SethNeumann/MRCS-Dual-3-Position-Semaphore-Controller/MRCS-Dual-3-Position-Semaphore-Controller v16.brd

## EAGLE design MRCS-Dual-3-Position-Semaphore-Controller v16.brd (2025-08-24)

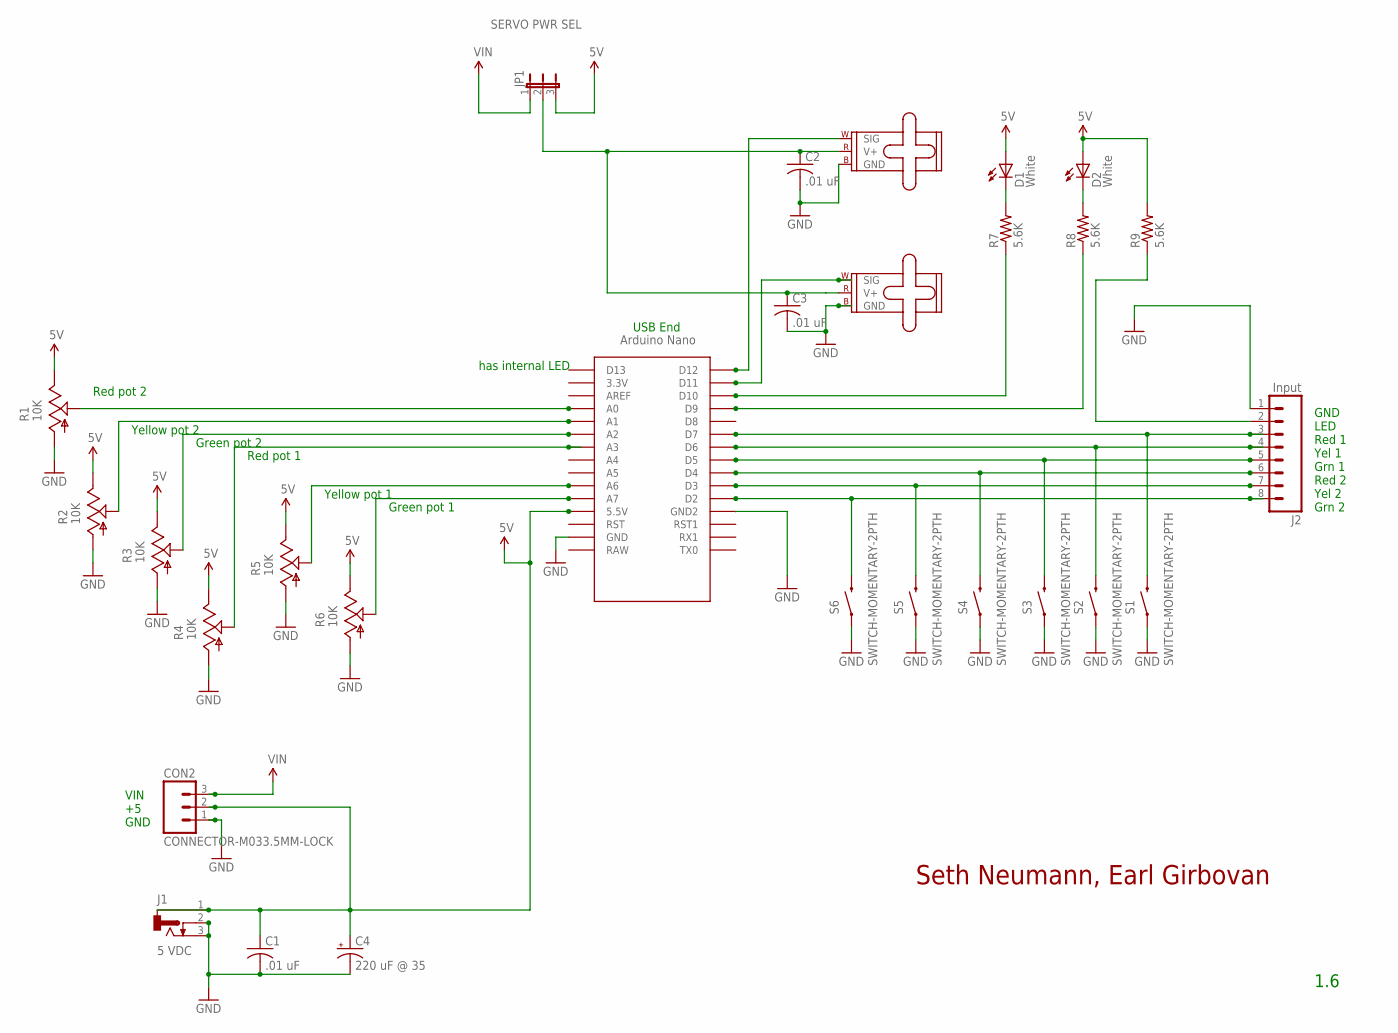
[picture p37: schematic MRCS-Dual-3-Position-Semaphore-Controller v16.sch]

Parts:
C1, C2, C3: .01 uF; C050-024X044
C4: 220 uF @ 35; E5-10.5
CON2: CONNECTOR-M033.5MM-LOCK; SCREWTERMINAL-3.5MM-3_LOCK.007S
D1, D2: White; LED3MM
J1: 5 VDC; DCJ0202
J2: Input; 1X08_LOCK
JP1: SERVO PWR SEL; 1X03
M1, M2: SMALL_SERVO; 1X03
NANO: NANO
R1, R2, R3, R4, R5, R6: 10K; RS3
R7, R8, R9: 5.6K; AXIAL-0.4
S1, S2, S3, S4, S5, S6: SWITCH-MOMENTARY-2PTH; TACTILE-PTH

Connections:
5V: C1.1, C4.+, CON2.2, D1.A, D2.A, J1.1, JP1.3, NANO.5V (5.5V), R1.E, R2.E, R3.E, R4.E, R5.E, R6.E, R9.P$2 (2)
A0: NANO.A0, R1.S
A1: NANO.A1, R2.S
A2: NANO.A2, R3.S
A3: NANO.A3, R4.S
A6: NANO.A6, R5.S
A7: NANO.A7, R6.S
D2: J2.8, NANO.D2, S6.3 (2)
D3: J2.7, NANO.D3, S5.3 (2)
D4: J2.6, NANO.D4, S4.3 (2)
D5: J2.5, NANO.D5, S3.3 (2)
D6: J2.4, NANO.D6, S2.3 (2)
D7: J2.3, NANO.D7, S1.3 (2)
D10: NANO.D10, R7.P$1 (1)
D11: M2.1 (SIG), NANO.D11
D12: M1.1 (SIG), NANO.D12
GND: C1.2, C2.2, C3.2, C4.-, CON2.1, J1.2, J1.3, J2.1, M1.3 (GND), M2.3 (GND), NANO.GND, NANO.GND1 (GND2), R1.A, R2.A, R3.A, R4.A, R5.A, R6.A, S1.1, S2.1, S3.1, S4.1, S5.1, S6.1
unnamed: J2.2, R9.P$1 (1)
unnamed: D1.K (C), R7.P$2 (2)
unnamed: D2.K (C), R8.P$2 (2)
unnamed: NANO.D9, R8.P$1 (1)
SERVO_SUP: C2.1, C3.1, JP1.2, M1.2 (V+), M2.2 (V+)
VIN: CON2.3, JP1.1

Notes on the sheet:
has internal LED
Red pot 2
Yellow pot 2
Green pot 2
Red pot 1
Yellow pot 1
Green pot 1
GND LED Red 1 Yel 1 Grn 1 Red 2 Yel 2 Grn 2
USB End
Seth Neumann, Earl Girbovan
1.6
VIN +5 GND

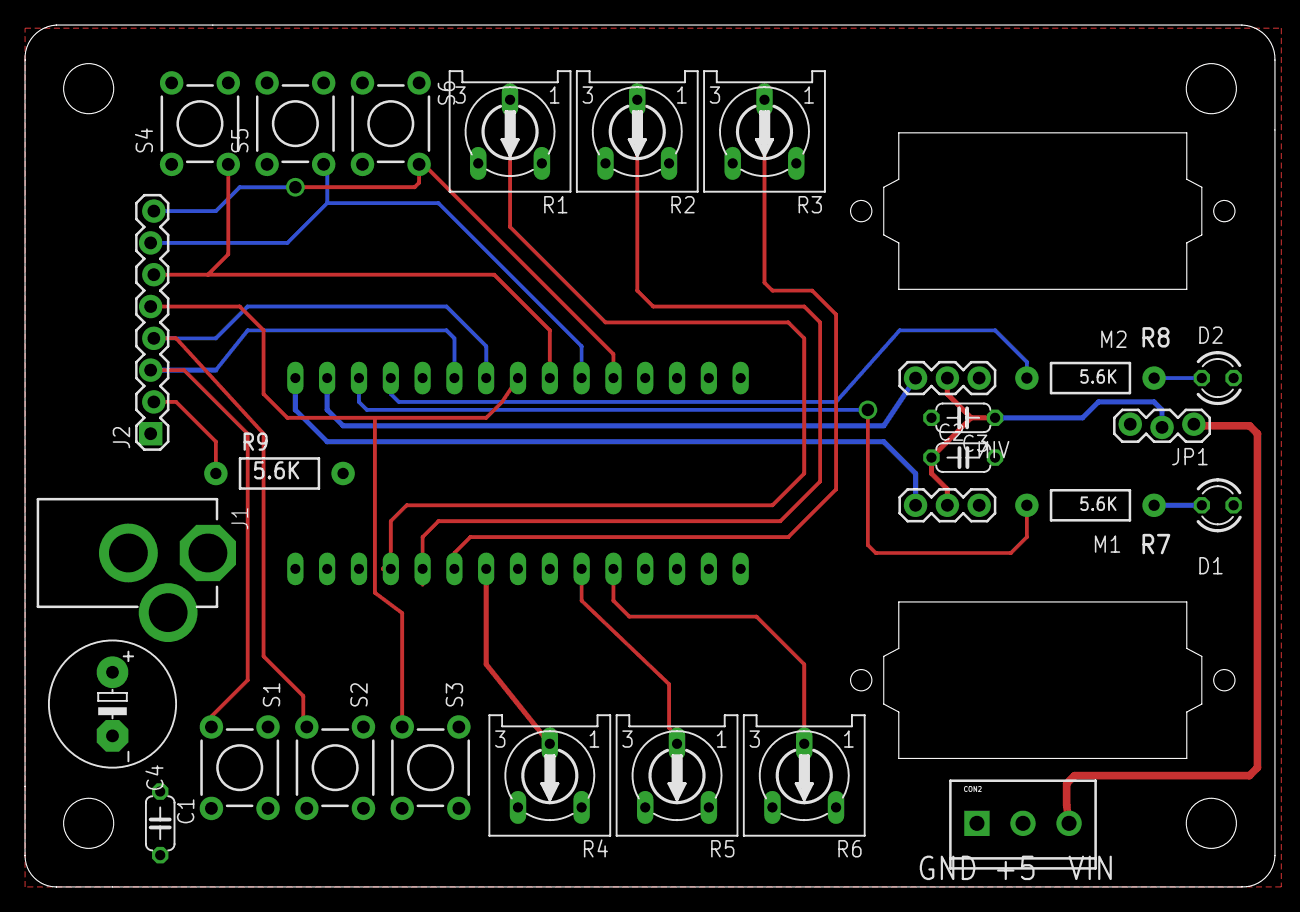
[picture p38: board MRCS-Dual-3-Position-Semaphore-Controller v16.brd from above]

Board: 2 copper layers, 99.8 x 68.8 mm, 33 parts (0 on the bottom side), 23 nets.

Other parts of the board:
U$1: BOARD-DINRAIL-2.7IN
U$2, U$4: SERVO-9G
U$3: MRCSLOGOBTM
U$5: CA-PROP65WARNING
