SethNeumann/MRCS-Dual-3-Position-Semaphore-Controller/(commit log)

2020-12-28 renumbered board
    used run cmd-renumber
    [EagleTemplate-new.brd, EagleTemplate-new.sch, MRCS-Dual-3-Position-Semaphore-Controller.brd, MRCS-Dual-3-Position-Semaphore-Controller.sch]
2021-08-03 Version 1.o documentation package
    includes documentation, brd, sch, zip, and sketch
    [MRCS-Dual-3-Position-Semaphore-Controller.brd, MRCS-Dual-3-Position-Semaphore-Controller.sch]
2022-11-14 changed +5 screw term to LED+ out for showcase
    Showcase Miniatures suggested an output for LED to illuminate roundel. Added a resistor and repurposed the old +5 screw terminal for LED power
    [MRCS-Dual-3-Position-Semaphore-Controller v12.brd, MRCS-Dual-3-Position-Semaphore-Controller v12.sch]
2023-11-21 updated documentation to show resistor R9 in V1.1
2023-11-22 adding caps to work better with cheap servos
    adding caps to work better with cheap servos. One electrolytic and 3 .01 uF (103)
    [MRCS-Dual-3-Position-Semaphore-Controller v13.brd, MRCS-Dual-3-Position-Semaphore-Controller v13.sch]
2023-11-26 updates based on Holbrook's crew
    added 3.5mm power terminal, added filter caps for noisy servos
    [MRCS-Dual-3-Position-Semaphore-Controller v13.brd, MRCS-Dual-3-Position-Semaphore-Controller v13.sch]
2025-08-24 uploaded 200250824
    Version 1.6 sch and brd files, updated documentation
    [MRCS-Dual-3-Position-Semaphore-Controller v16.brd, MRCS-Dual-3-Position-Semaphore-Controller v16.sch]
